Moulik-Budhiraja/Nail-Braille/models/Braile Disk Version v4 With Supports.stl

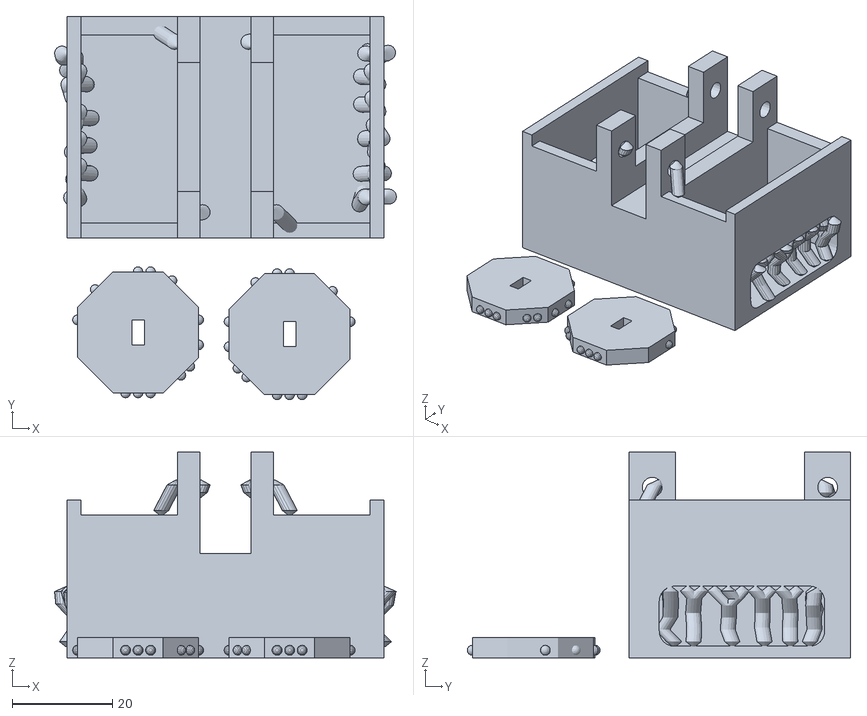
[picture p2: CAD file, 2023-04-11]
models/Braile Disk Version v4 With Supports.stl
68.2 x 76.5 x 41.0
