Moulik-Budhiraja/Nail-Braille/(commit log)

2023-04-11 Add 3D Model
    [Braile Disk Version v4 With Supports.stl]
2023-04-27 Refactor: Clean Braille.ino and improve reliability of ESP32
